saiprashanth802/custom-speakers/v1-passive-bookshelf/images/setup_full.jpg

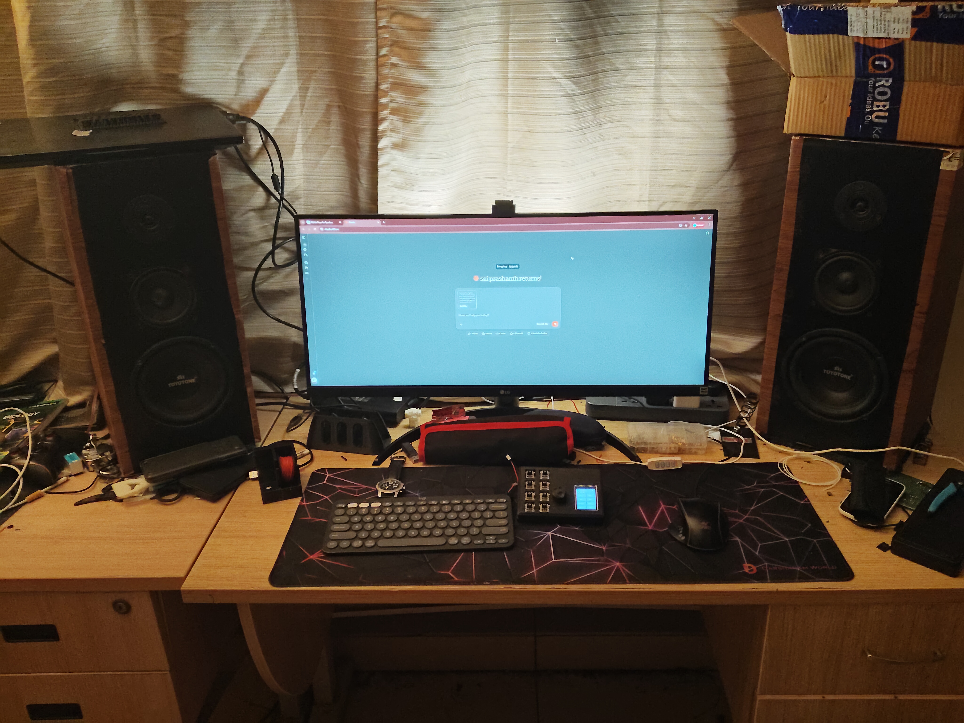
v1-passive-bookshelf/images/setup_full.jpg
