saiprashanth802/custom-speakers/v1-passive-bookshelf/images/internals_woofer.jpg

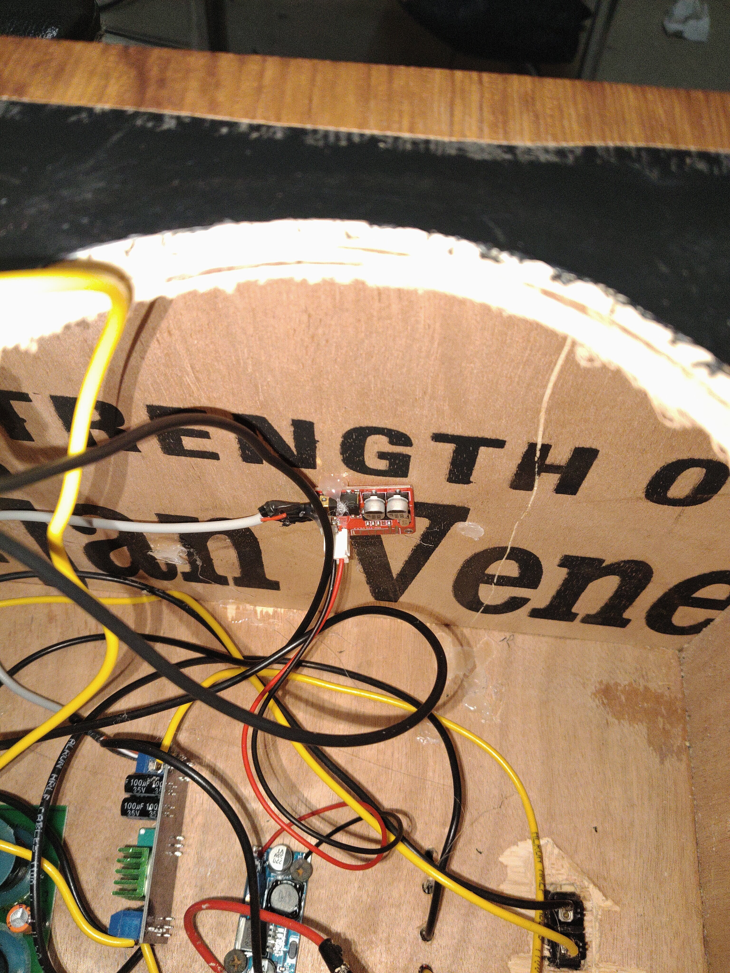
v1-passive-bookshelf/images/internals_woofer.jpg
