saiprashanth802/custom-speakers/v1-passive-bookshelf/schematics/README.md

# Schematics

Schematic files will be added here.

Planned:
- `crossover-schematic.pdf` — passive crossover network with component values
- `wiring-diagram.pdf` — full internal wiring from AC input to drivers
- `signal-chain.pdf` — signal path from BT module through amps to crossover
