saiprashanth802/custom-speakers/v1-passive-bookshelf/images/README.md

# Images

Place build photos in this folder. Recommended shots:

| Filename | What to photograph |
|---|---|
| `front.jpg` | Full front view of both cabinets, drivers visible |
| `back-panel.jpg` | Back panel — AC socket, rocker switch, binding posts, volume pots |
| `internal.jpg` | Inside the cabinet — amp modules, crossover, wiring |
| `crossover.jpg` | Close-up of the passive crossover network and hand-wound inductors |
| `drivers.jpg` | Close-up of the three drivers on the front baffle |
| `setup.jpg` | Full listening setup — both cabinets in position |

Photos should be taken before final closeup if possible. JPEG at 1080p or higher is fine.
