saiprashanth802/custom-speakers/amp/companion/screenshots/bench-44biquad-96k-2026-09-15.png

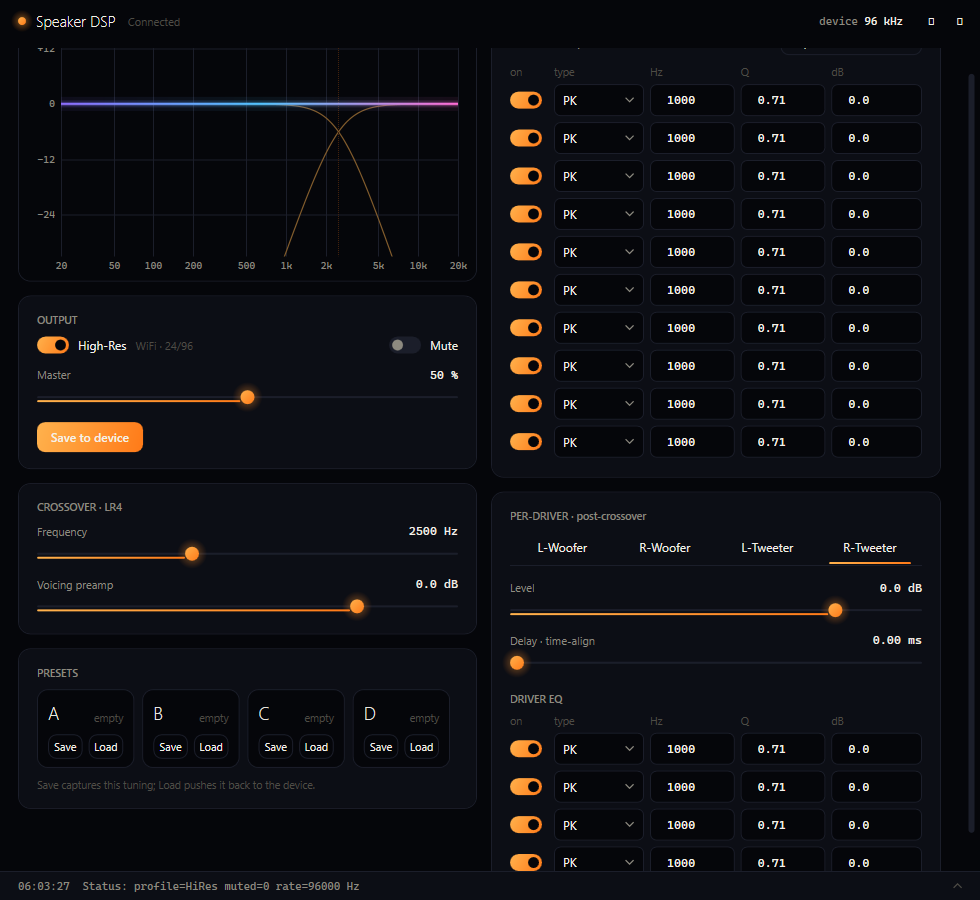
amp/companion/screenshots/bench-44biquad-96k-2026-09-15.png
