saiprashanth802/custom-speakers/amp/companion/screenshots/void-deck-2026-09-15.png

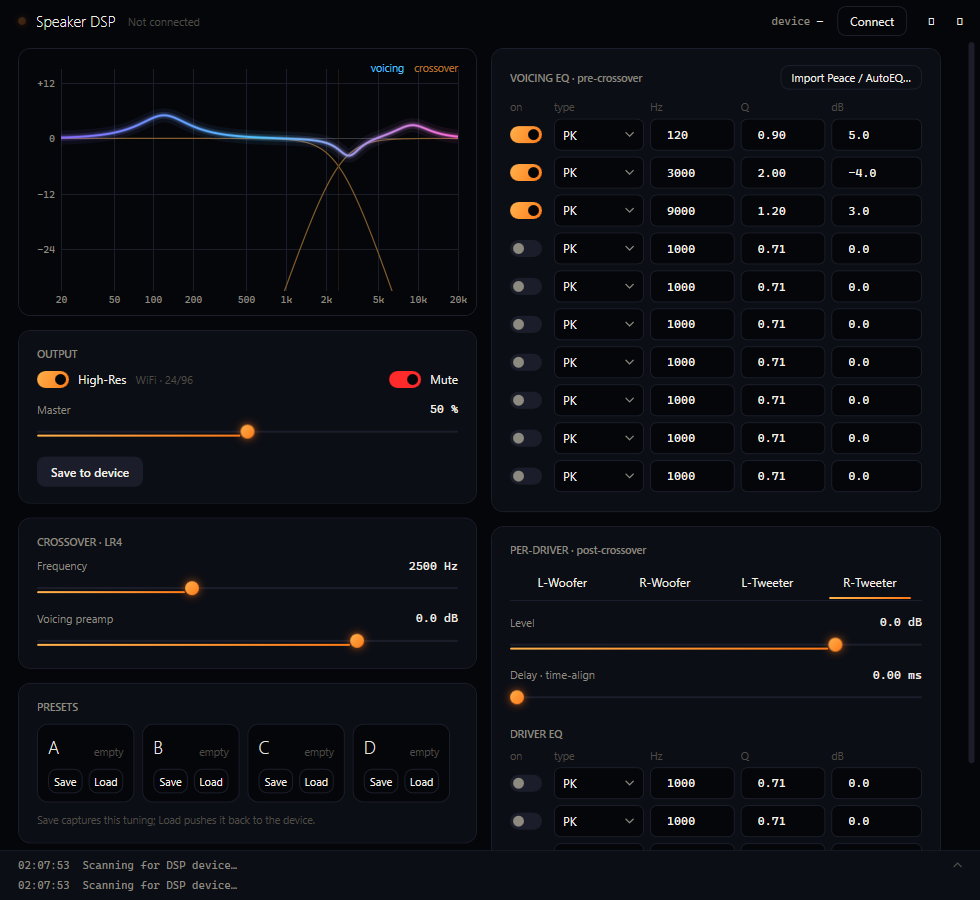
amp/companion/screenshots/void-deck-2026-09-15.png
