saiprashanth802/custom-speakers/v1-passive-bookshelf/images/back_panel.jpg

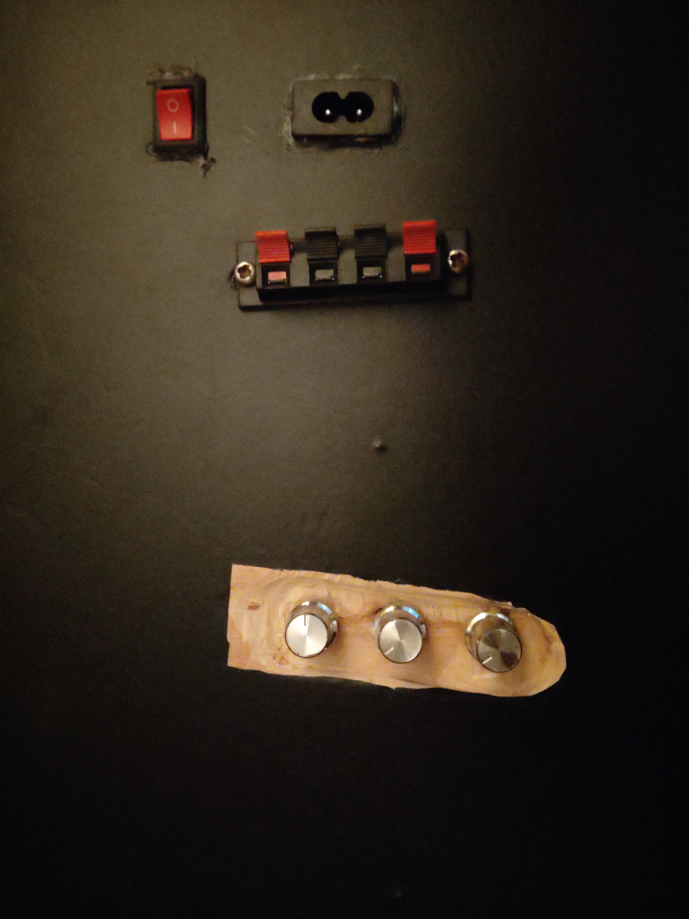
v1-passive-bookshelf/images/back_panel.jpg
