saiprashanth802/custom-speakers/v1-passive-bookshelf/images/driver_sub.jpg

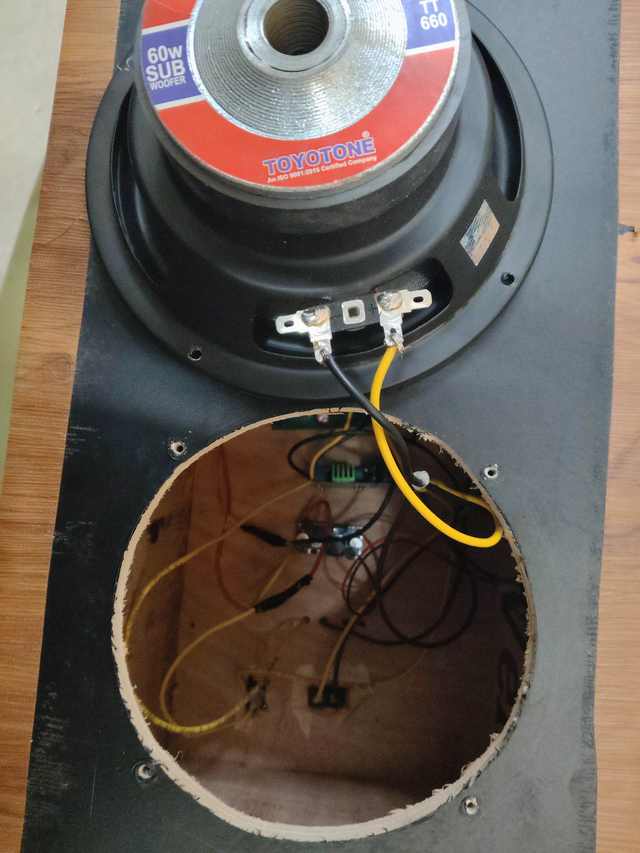
v1-passive-bookshelf/images/driver_sub.jpg
