saiprashanth802/custom-speakers/v1-passive-bookshelf/images/front_drivers.jpg

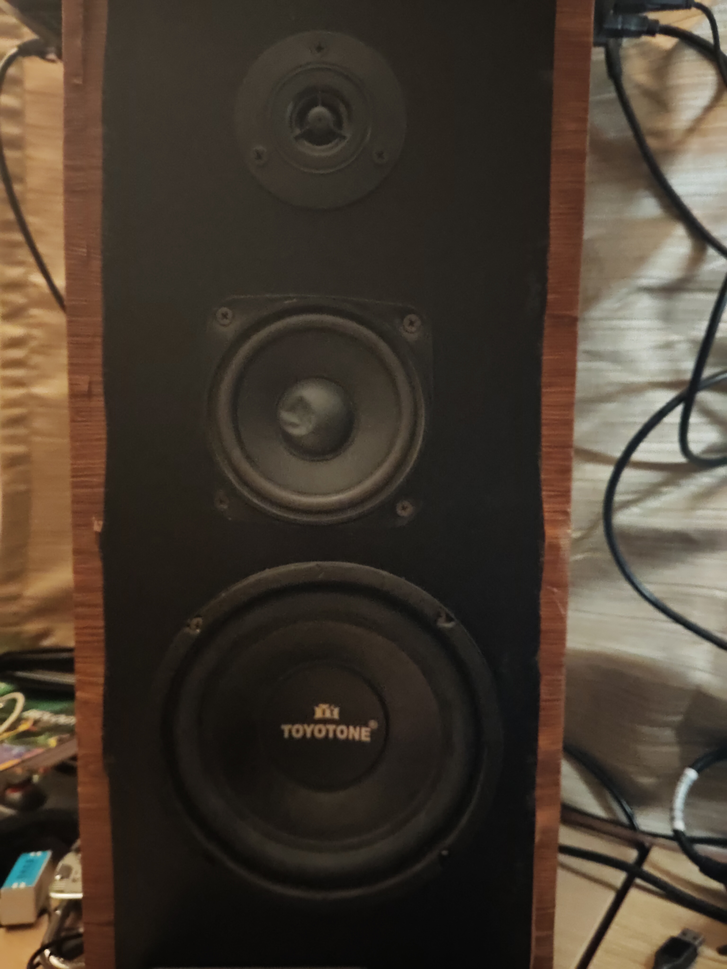
v1-passive-bookshelf/images/front_drivers.jpg
