saiprashanth802/custom-speakers/v1-passive-bookshelf/images/internals_full.jpg

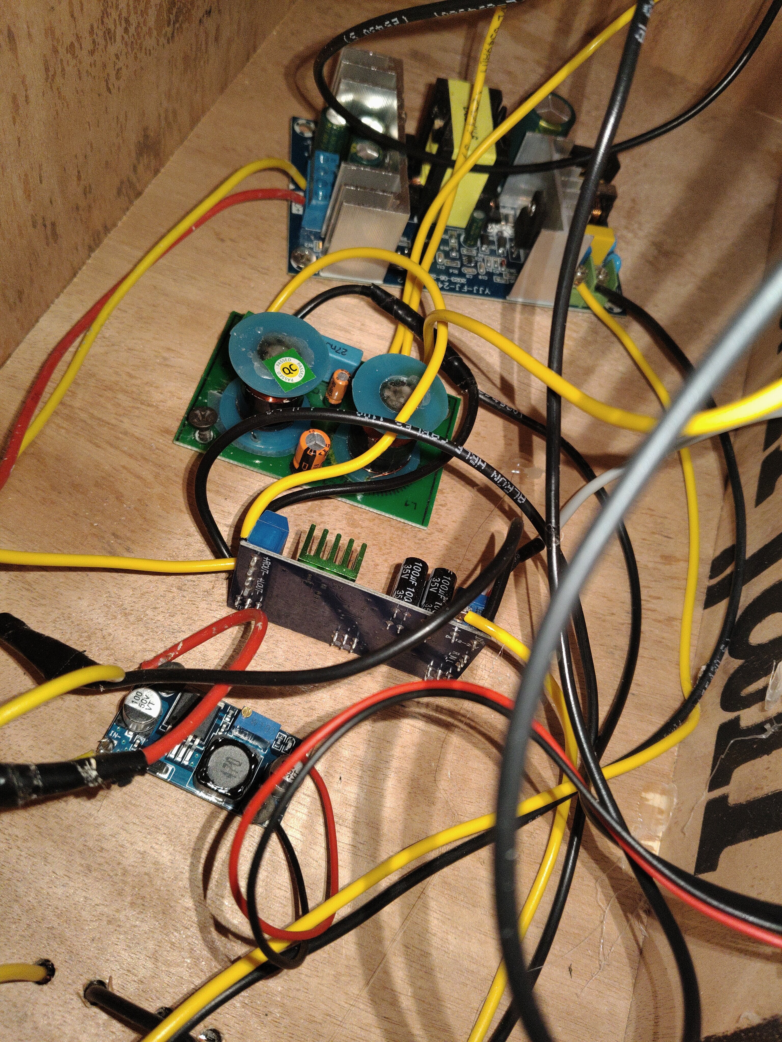
v1-passive-bookshelf/images/internals_full.jpg
