saiprashanth802/custom-speakers/v1-passive-bookshelf/2_way bookshelf_Speakers_BOM.xlsx

DIY 2-WAY BOOKSHELF SPEAKER — BILL OF MATERIALS
Complete stereo pair build · Hyderabad, India · 2024
# | Component | Description / Specs | Source | Qty | Unit (₹) | Total (₹) | Notes
DRIVERS
1 | DS-52G060 woofer | 5.25" 8Ω 60W RMS, glass fiber cone, double magnet | Doogesound | 2 | ₹1800 | ₹3600 | Confirm 8Ω version — NOT 4Ω
2 | DE15-04 tweeter | 1" silk dome, 8Ω, 40W, European diaphragm | Doogesound | 2 | ₹700 | ₹1400 | Sensitivity pad: 4.7Ω series resistor
CROSSOVER COMPONENTS
3 | MKPA-S 6.8µF cap | Polypropylene film, 250VDC, ±3% | Doogesound | 4 | ₹79 | ₹316 | C1 + C3 tweeter HP (×2 per cab)
4 | MKPA-S 10µF cap | Polypropylene film, 250VDC, ±3% | Doogesound | 2 | ₹119 | ₹238 | C2 woofer shunt — parallel with 3.3µF
5 | MKPA-S 3.3µF cap | Polypropylene film, 250VDC, ±3% | Doogesound | 2 | ₹59 | ₹118 | C2 woofer shunt — parallel with 10µF
6 | 4.7Ω 10W resistor | Non-inductive wirewound, 5% tolerance | Doogesound | 2 | ₹49 | ₹98 | Tweeter sensitivity pad — 4dB attenuation
7 | 0.42mH inductor (L1/L3) | Air core, 0.5mm enamel wire, 25mm PETG former | Wind yourself | 4 | — | — | 3 layers × 75 turns, wire from Gujarati Gali
8 | 0.85mH inductor (L2) | Air core, 22SWG enamel wire, 35mm PETG former | Wind yourself | 2 | — | — | 4 layers × 46 turns on 35mm former
AMPLIFIER SYSTEM
9 | TPA3255 amp board | 300W×2 Class D, TI PurePath, 0.006% THD | Maker Bazar | 1 | ₹2500 | ₹2500 | Run at 36V → ~63W/ch into 8Ω
10 | 36V 10A SMPS | 360W, metal case, EMI filtered, overcurrent prot. | Maker Bazar | 1 | ₹1600 | ₹1600 | Do NOT use 48V — exceeds safe driver power
11 | XH-A901 tone preamp | NE5532 dual op-amp, bass/treble/volume | Maker Bazar | 1 | — | — | Included in Maker Bazar cart
12 | Buck converter 36V→12V | Powers XH-A901 tone preamp | Maker Bazar | 1 | — | — | Included in Maker Bazar cart
CABINET
13 | 12mm Gurjan BWR ply | 175×255×175mm ext, 8.0L net internal | Local timber | 2 | ₹175 | ₹350 | Per cabinet: 2×front/rear, 2×top/bot, 2×sides
14 | Port duct (PETG print) | 80×20mm slot, 93mm deep, 3mm walls | 3D print | 2 | ₹30 | ₹60 | 60% gyroid infill, seals with silicone
15 | Inductor bobbins (print) | 25mm + 35mm formers, PETG | 3D print | 6 | ₹5 | ₹30 | 4× L1/L3 bobbin + 2× L2 bobbin
16 | Acoustic polyfill | ~0.5m² per cabinet, rear + side walls | Local / Amazon | 1 | ₹100 | ₹100 | Do NOT stuff port area
17 | Speaker binding posts | Banana/spade type, 2 per cabinet | Gujarati Gali | 4 | ₹20 | ₹80 | Mount on rear panel, 40mm from bottom
18 | Wood screws + glue | PVA wood glue + silicone sealant | Local hardware | 1 | ₹120 | ₹120 | Silicone all internal seams — airtight critical
WIRING & CONNECTIONS
19 | 22SWG enamel copper wire | For L2 inductor winding, 50m spool | Gujarati Gali | 2 | ₹250 | ₹500 | 44m needed + buffer — ~₹4–5/m local price
20 | 0.5mm enamel wire | For L1/L3 inductors — already owned | Already owned | 1 | — | — | 42m needed from 50m spool
21 | 16AWG speaker wire | Internal cabinet wiring, ~2m per cab | Local market | 1 | ₹80 | ₹80 | Keep power + signal wires separated
22 | RCA cable | 3.5mm to dual RCA, shielded, ~1m | Amazon India | 1 | ₹80 | ₹80 | DAC → XH-A901 → TPA3255
23 | Perfboard | For crossover board assembly | Gujarati Gali | 2 | ₹25 | ₹50 | One per cabinet, solder components
SOURCE
24 | HZ × ddHiFi USB-C DAC | CX31993 chip, 105dB SNR, 384kHz/32bit | Already owned | 1 | — | — | Already owned — best quality source chain
TOTAL BUILD COST (complete stereo pair) |  |  |  |  |  | ₹11320
Commercial equivalent value (passive speakers + same amp) |  |  |  |  |  | ₹22,000–28,000
You save |  |  |  |  |  | ~₹10,000–16,000
CRITICAL BUILD NOTES
⚠ | Tweeter polarity |  | Wire tweeter in REVERSE polarity (swap + and −). Required for 3rd order Butterworth — 270° phase shift.
⚠ | Port clearance |  | Side port needs minimum 80mm wall clearance. Port on RIGHT side panel only.
✓ | Inductor winding |  | L1/L3: 0.5mm wire, 25mm former, 3 layers × 75 turns. L2: 22SWG, 35mm former, 4 layers × 46 turns.
✓ | Cabinet sealing |  | Seal ALL internal joints with PVA glue + thin silicone bead. Any air leak detunes port and kills bass.
✓ | First test |  | Wire everything before permanently sealing cabinet. Play 30 mins, check coils for heat, verify both drivers.
✓ | Power supply |  | Run TPA3255 at 36V only. Do NOT use 48V PSU directly — delivers 115W into 60W driver. Use SMPS directly.
✓ | Listening distance |  | Minimum 80cm, ideal 1–1.5m. Toe-in 10–15° toward listening position. Tweeter at ear level.
