saiprashanth802/custom-speakers/(commit log)

2026-06-02 Add full documentation
    [bill_of_materials.csv]
2026-06-02 Add full documentation and BOM-based README
    [2_way bookshelf_Speakers_BOM.xlsx]
2026-09-14 Initial import: speaker DSP crossover as verified on hardware 2026-08-23
    Firmware (dsp_engine, channel_test), companion app SpeakerDspDeck, and docs
    (WIRING, DSP, INTERFACE, PROTOCOL v1, schematic). State matches the memory /
    hardware-handoffs record: BLE end-to-end, NVS, 48k/96k profile switch, presets
    and per-driver EQ all verified on the bench on 2026-08-23.
2026-09-14 fw: boot-profile restore, LOAD_PRESET rate fix, post-switch status, GET_PARAMS read-back
    COMPILED ONLY (2026-09-15, board not attached): 648199 B / 49% flash, 21% RAM.
    - loadParamsBlob(key, p, forceRate): boot keeps the blob's rate so the saved
    profile is restored and I2S starts at it directly; runtime LOAD_PRESET forces
    the running (or pending) rate. Fixes a latent bug where a preset loaded in
    High-Res was designed for 48 k (every corner at 2x).
    - saveParamsBlob writes the intended rate (pending switch wins).
    - audioTask sets g_rateChanged after a switch; loop() sends EVT_STATUS so the
    app sees the final rate. BLE is never called from the audio core.
    - CMD_GET_PARAMS 0x03 -> loop()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
    [dsp_engine.ino, protocol.h]
2026-09-14 app: GET_PARAMS read-back on connect, device rate display; PROTOCOL.md addendum
    Builds clean (0 warn / 0 err, .NET SDK 9.0.318 reinstalled after the wipe).
    Not exercised against hardware: board not attached 2026-09-15.
    - On HELLO OK the app now sends GET_PARAMS and applies the 39 EVT_PARAM frames
    silently (no echo) via a _silent guard on every scalar setter plus
    DriverRow.LoadLevel/DelaySilently. PARAMS_DONE logs the count; a 3 s
    DispatcherTimer or a 0xFF NAK falls back to the old PushAll, so fw 1 still
    works unchanged.
    - EVT_STATUS now syncs profile + mute silently and feeds DeviceRateHz /
    DeviceRateText, shown beside the High-Res toggle; the firmware's post-switch
    STATUS is wh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
2026-09-14 app: "Void Deck" redesign + live response curve
    Direction from the taste skill (angelcore x cloud-trance) applied to a hi-fi
    control surface: a dark void with one warm light. Ember is the only accent on
    dark surfaces (thumbs, toggles, selected tab, connected dot); red is used
    exactly once (Mute); iridescence belongs to the response curve alone.
    - Controls/ResponseCurve.cs: OnRender hero showing the voicing EQ magnitude
    response (iridescent, glow) and the LR4 branches (gold) on a log grid.
    Model/Response.cs ports the RBJ designs from firmware biquad.h so the app
    draws what the device computes. Recomputed on every band/crossover/preamp/
    rate change. The app had no EQ feedback before.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
2026-09-15 bench 2026-09-15: readback branch VERIFIED ON HARDWARE; STATUS pull after read-back; halo instead of effects
    All six steps of the bench procedure passed on the board (COM3 now, was COM16):
    1. boot: 'restored params from NVS (saved rate 48000 Hz)' / 'running @ 48000 Hz (Normal)'
    2. connect: HELLO -> GET_PARAMS -> 'params dump: 39 frames' -> app 'Loaded device
    state (39 of 39 params)'; UI reflected the device's NVS state, no push burst
    3. High-Res toggle: two STATUS frames, second at 96000; title bar 'device 96 kHz';
    load 12.6% -> 25.5% (exact 2x)
    4. Save in High-Res + hard reset: 'saved rate 96000 Hz' / 'running @ 96000 Hz (High-Res)'
    5. 44 biquads @ 96 kHz: 74.9% of one core, 42.5 cyc/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
    [dsp_engine.ino]
2026-09-15 uac_test: USB Audio Class 1.0 speaker test firmware + Windows bench tool
    Arduino sketch that adds TinyUSB's audio class (audio_device.c, upstream commit
    6e891c6dc — the exact one arduino-esp32 3.3.6's prebuilt libtinyusb was built from,
    which ships every class except audio) through usbd_app_driver_get_cb(), and streams
    the ISO OUT endpoint straight to the LOW DAC over I2S. One format per build via
    -DUAC_RATE/-DUAC_BYTES; PID derived from the format so Windows treats each as a new
    device.
    Measured on the bench 2026-09-15 (Windows 11, exclusive-mode WASAPI, 1 kHz tone):
    24/48 OK 1000 pkt/s, 48000 frames/s, feedback FIFO steady
    16/88.2 OK 1000 pkt/s, 88200 frames/s
    24/96 FAIL wit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
    [audio_device.c, uac_config.h, uac_desc.h, uac_glue.cpp, uac_test.ino]
2026-09-15 docs: USB-C UAC is the audio source at both rates (measured 2026-09-15)
    WIRING.md and INTERFACE.md said native USB caps at 24/48 and WiFi is the only
    96 k source. Bench result: 24/96 over USB works (with the RX-FIFO workaround);
    the ceiling was the S3 FIFO + TinyUSB's allocation rule, not full-speed USB.
2026-09-15 dsp_engine: USB audio source merged in (UAC1, 24-bit, 48k/96k) + 4-GPIO amp mute
    The PC's USB stream replaces the tone generator as the engine's input. TinyUSB's
    audio class rides along as in uac_test (audio_device.c + uac_glue.cpp, prebuilt
    commit 6e891c6dc). One descriptor advertises 48000 and 96000; the engine's rate
    follows the host's SET_CUR through the existing mute -> re-clock -> re-design
    switch, and the app's High-Res toggle is refused (ACK 3) while a stream owns the
    rate. I2S moves to 24-in-32 slots on both DACs. RX FIFO enlarged to 1x packet at
    stream start (the S3/TinyUSB ceiling found in uac_test). USB.begin() runs from a
    core-0 task so the USB interrupt lands next to BLE. Conso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
    [audio_device.c, dsp_engine.ino, protocol.h, uac_config.h, uac_desc.h, uac_glue.cpp]
2026-09-15 bench 2026-09-15: usb-dsp VERIFIED ON HARDWARE — status claims corrected
    Merged engine on the bench with the app connected over BLE: 24/48 and 24/96
    streamed through the full chain (1000 pkt/s, feedback FIFO steady, no
    underruns in steady state), the engine re-clocked on the host's SET_CUR and
    the app showed the unsolicited STATUS (device 96 kHz), SET_PROFILE mid-stream
    returned ACK 3 and the toggle snapped back, 44 biquads @ 96 k = 75.3-75.9 %
    with USB live. Not yet: listened to by ear, mute NPNs wired.
    [dsp_engine.ino]
2026-09-15 companion: fit FilterCurve (graphic EQ) exports to the ten voicing bands
    The user's speaker measurement is an Audacity/REW FilterCurve (50 points), which
    the importer read as zero bands. FilterCurveFitter: greedy band placement on the
    largest residual (PK at five Qs, or a low/high shelf near the ends), coordinate
    descent on F/Q/gain against the app's RBJ response, weighted 30 Hz-18 kHz, preamp
    from the curve maximum. On the real curve: RMS 0.08 dB, worst 0.3 dB, 72 ms.
    Imported and saved as the device's boot default on the bench (28 biquads, 25.8 %
    @ 48 k, 20 s stream with zero underruns). presets/ keeps both tunings.
2026-09-15 companion: full-range check (crossover parked at 20 kHz) for IEM/headphone listening on the LOW DAC
    Slider stays at the real crossover and is disabled while the check is on; a
    device read-back >= 19 kHz lands on the check instead of the 6 kHz-capped
    slider; presets clear it; the response curve draws the parked crossover.
2026-09-15 presets: Sennheiser HD 600 (Peace → APO text; Peace filter-code map)
2026-09-16 dsp_engine: apply the host's USB volume and mute to the stream
    Windows' volume slider did nothing: the feature-unit SET_CUR requests were
    answered and stored but never applied, and in exclusive mode Windows cannot
    attenuate in software. The USB input is now scaled by the host's mute/volume,
    ramped per sample (~5 ms @ 96 k) so slider moves do not zipper.
    Measured: Windows writes the SAME dB to master and to both channels
    ("vol -10/-10/-10"), so master and channel must not be summed — the more
    attenuated of the two is used. The status line now shows the host's
    volume/mute. Bench 2026-09-16: 50 % -> -10 dB, 100 % -> 0 dB, mute -> MUTED.
    Also carried in from the uncommitted bench work: I2S_1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
2026-09-16 companion: reconnect after the device reboots (BleLink drop-before-attempt)
    Symptom: after a board reset/reflash the app logged "Disconnected." then
    "Scanning for DSP device…" and never connected again until relaunched.
    Cause: OnConnStatus nulled the characteristics but left _device alive, and
    OnAdvReceived skips every advert while _device is non-null — so the rescan
    could never act. Failed ConnectTo paths (stale service list, missing chars)
    likewise returned with _device set and no rescan.
    Ported the MacroPadDeck BleLink pattern: Drop() (dispose device/service,
    unhook events) before every attempt and on every failure, one attempt at a
    time via a gate, uncached full service enumeration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
2026-09-16 WIRING.md: PCM5102 config pins as built (CJMCU-5102 bridges), the crossed LCK/DIN find
    Both DACs verified by ear 2026-09-16. Records the H1L-H4L bridge settings,
    that SCL has no bridge and must be a wire to GND, and the two-step
    silent-DAC diagnosis (tone build, then move the known-good module's wires).
2026-09-16 WIRING.md: VCC row back inside the config table
2026-09-19 Move the 2024 passive build into v1-passive-bookshelf/ (tagged v1)
    [2_way bookshelf_Speakers_BOM.xlsx, bill_of_materials.csv]
2026-09-19 v2 restructure: speaker/ (cabinets, enclosure conversion) + amp/ (DSP/amp unit README from the handoffs); top-level README
2026-10-02 amp docs: mains input wiring, WX-DC2416 PSU, corrected power budget
    - schematic.html §5: mains chain (C13 cord -> C14 inlet -> T3.15A fuse ->
    DPST switch -> PSU), earth wire straight from inlet to PSU (3D-printed box)
    - §5b: rear-tab wiring for the owned Electronic Spices AC-01A 3-in-1 module
    (two jumpers inlet -> switch), with meter checks to find the fused tab and
    the switch poles
    - §5c: to-scale WX-DC2416 open-frame board: earth via the marked M4 hole,
    nylon hardware on the other holes, live primary side, heat, DC terminals
    - Power budget corrected from "150 W / 6.25 A" to the datasheet's 5.5 A
    nominal / 6 A peak (140 W); overload trips OCP (dropout) rather than sagging
    - WIR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
2026-10-04 dsp_engine: don't restore a full-range-check crossover at boot; 500 Hz tweeter floor; log crossover + levels
2026-10-06 companion: high-pass type on driver EQ bands; master slider in dB
    Driver bands can now select HighPass (firmware already designs any FilterType),
    so a woofer subsonic filter shows and edits properly.
    Master slider was linear 0-100 % of gain: 70 % = -3 dB, 30 % = -10.5 dB, so the
    audible range sat in the bottom third and the slider felt dead. It now binds
    MasterDb (-60..0 dB, bottom = off). Presets and the wire format still carry
    linear MasterPct, so saved presets load unchanged.
